PattyMac-17/NU_CIGHT_TB_Sonicator/(commit log)

2026-06-02 Adding motor control code
2026-06-02 cleaning up print statements
2026-06-10 Rename Mean Well ACDC Converter 24V 350W LRS-350.pdf to Mean Well ACDC Converter 24V 350W LRS-350.pdf
    removing colon from name
2026-06-10 uploading cad files
2026-06-10 added wiring guide
